TrungKuro/Servo_7Seg_Clock/(commit log)

2023-08-22 Fix Servo chạy loạn.
    [Control_Clock.cpp, Control_Clock.h, Pin_Config.h]
2023-08-22 Fix Servo chạy loạn (1) - Chỗ giữa setup() và loop().
    [7Seg_Clock_Servo.ino, Pin_Config.h]
2023-08-22 Fix phần hiển CRY - BOX - FRONZEN.
    [7Seg_Clock_Servo.ino, Control_Clock.cpp, Pin_Config.h]
2023-08-22 Fix (2) phần hiển CRY - BOX - FRONZEN.
    [7Seg_Clock_Servo.ino, Control_Clock.cpp, Control_Clock.h, Pin_Config.h]
2023-08-23 Bỏ chế độ ngủ, thay bằng xuất xung OFF.
2023-08-23 Hoàn thiện nội dung README.
